ynnklx/testbench/README.md

# Testbench – motor and propeller test stand

A test stand to measure small brushless motors with propellers: **thrust,
current, voltage, RPM and ESC temperature**. It runs on a lab power supply.

The main goal is not the most precise number. The goal is a measurement
process that is **traceable, reproducible and honest about its errors**:
every result file says where it comes from, raw data is never changed, and
every point that looks wrong is marked, not deleted.

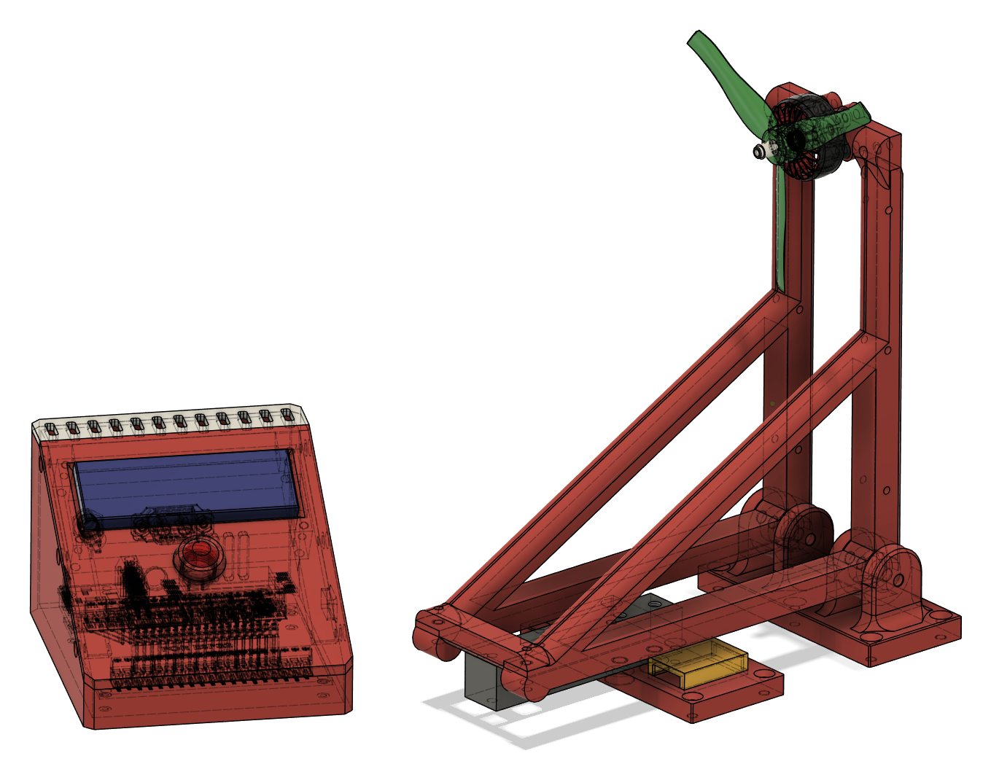
[picture p1: docs/images/title_render.png]
Test stand (CAD rendering): controller box and load cell rig


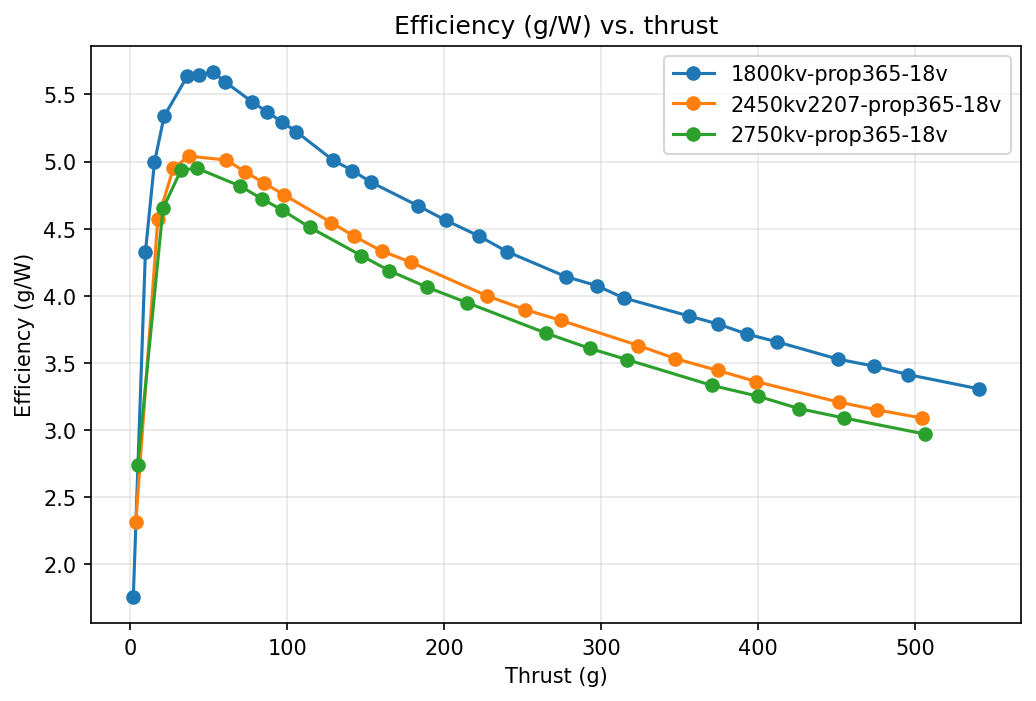
[picture p2: data/plots/Hauptmessreihe/1800kv-prop365-18v_vs_2450kv2207-prop365-18v_vs_2750kv-prop365-18v_efficiency_vs_thrust.png]
Efficiency vs. thrust, three motors at 18 V


*Efficiency (g/W) over thrust for three motors with the same propeller at
18 V. Each curve is the combination of two repeated runs.*

## Documentation

[Projektdokumentation (PDF, German)](docs/Testbench_Dokumentation_GER.pdf)

Full project documentation in German: concept, mechanical and electronic design,
test automation, validation and results. An English version is available on request.

## Video: Demo Run (YouTube)

Automated test run on the thrust stand (https://youtu.be/bWamTexU-FU)

Automated test run from start to finish: arming, 3 s countdown with zero-point capture,
throttle sweep up and down in 2.5% steps, and live data acquisition on the host PC.

## How it works

```
ESP32 firmware  ->  Acquisition  ->  Analysis  ->  Comparison  ->  Plots
 raw ADC counts      RAW.csv        ANALYZED.csv   COMPARISON.csv   *.png
```

- The **firmware** (ESP32, C++, PlatformIO) reads the load cell (HX711), the
  current/voltage sensor (INA226) and the ESC telemetry. It sends only raw
  values with a timestamp per sample. It drives the throttle sequence by
  itself: up to full throttle in 2.5 % steps and down again.
- The **host software** (Python) records the data, makes one measurement point
  per throttle stage, checks each point against rules (VALID / WARNING /
  INVALID), compares repeated runs and draws plots.
- Calibration happens on the host. So old data can be recalculated when the
  calibration changes.

Details and reasons for each decision: [docs/ARCHITECTURE.md](docs/ARCHITECTURE.md).

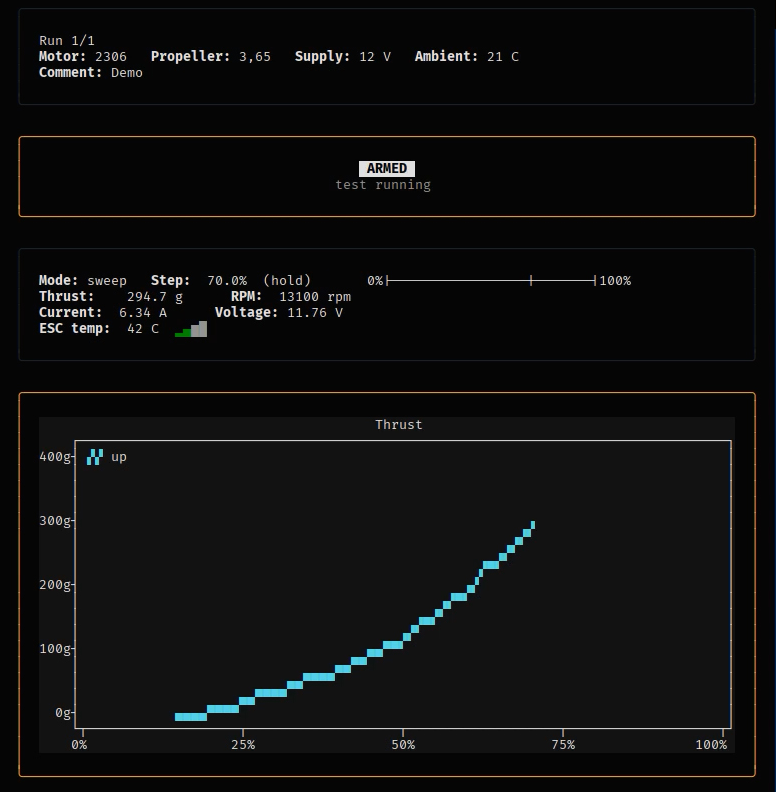
[picture p3: docs/images/session_live_view.png]
Live view during a sweep


*Live view of `testbench.py session` during a sweep (2306 motor, 12 V).*

## Validation

Before the main series, the measurement chain was checked against reference
weights, a multimeter and repeated runs. Repeated runs agree within about 1 %
for thrust and current, and the current measurement is within about 2 % of a
multimeter. Details in [docs/DEVLOG.md](docs/DEVLOG.md).

## Usage

Python 3.10 or newer.

```bash
pip install pyserial numpy pandas matplotlib rich textual textual-plotext
```

### Measuring with the test stand

The ESP32 is connected via USB (default port `/dev/ttyUSB0`, change with
`--port`). The run itself is started on the device with the arm button.

```bash
# Guided session: short setup questions, live view during the run,
# results and plots after the last repetition
python testbench.py session

# Or only record RAW files, without questions
python testbench.py record

# Load cell calibration with reference weights
python testbench.py calibrate
```

### Evaluating data

Every stage can also be started alone, for example to analyze old RAW files
again with a changed `validation.json`:

```bash
python testbench.py analyze data/raw/Hauptmessreihe/2026-09-17_13-58-33_sweep_1of2_RAW.csv
python testbench.py compare --label <name> <ANALYZED file> <ANALYZED file> ...
python testbench.py plot --kind g_per_w_vs_thrust <COMPARISON file> ...
```

Run `python testbench.py <command> --help` for all options.

### Development

- Firmware: `cd firmware && pio run`
- Tests: `python -m pytest`
- `record` and `session` accept `--simulate`. A built-in simulator then
  replaces the device, so the software can be tested without the test stand.
  The simulated values are not real measurements.

## Repository structure

| Path | Content |
|---|---|
| `firmware/` | ESP32 firmware: HX711 driver, INA226, ESC control and telemetry, serial protocol |
| `acquisition/` | Serial link (with simulator), recorder, guided session, calibration |
| `analysis/` | RAW → ANALYZED: measurement points, statistics, validation rules |
| `comparison/` | Run-to-run comparison and plots |
| `core/` | File names, CSV headers, units, calibration |
| `config/` | `calibration.json` (load cell fit), `validation.json` (all thresholds, each with its source) |
| `data/` | Real measurement data, see [data/README.md](data/README.md) |
| `tests/` | Automated tests (pytest) |
| `docs/` | Architecture, development log, [HX711 outlier finding](docs/findings/hx711-outlier.md) |

## Hardware

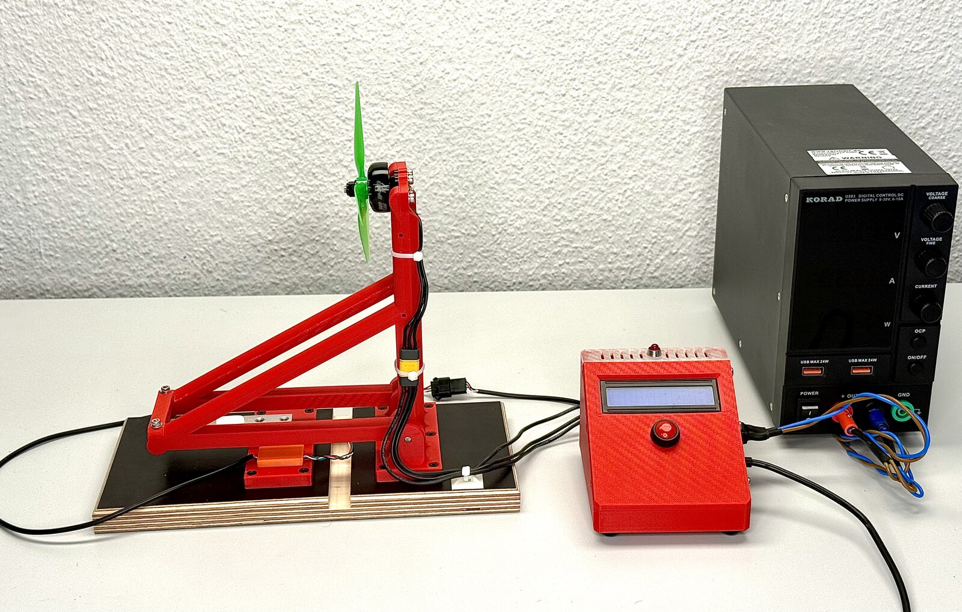
[picture p4: docs/images/setup.jpg]
Complete setup with lab power supply


*Load cell rig with motor and propeller (left), controller box (middle),
lab power supply (right).*

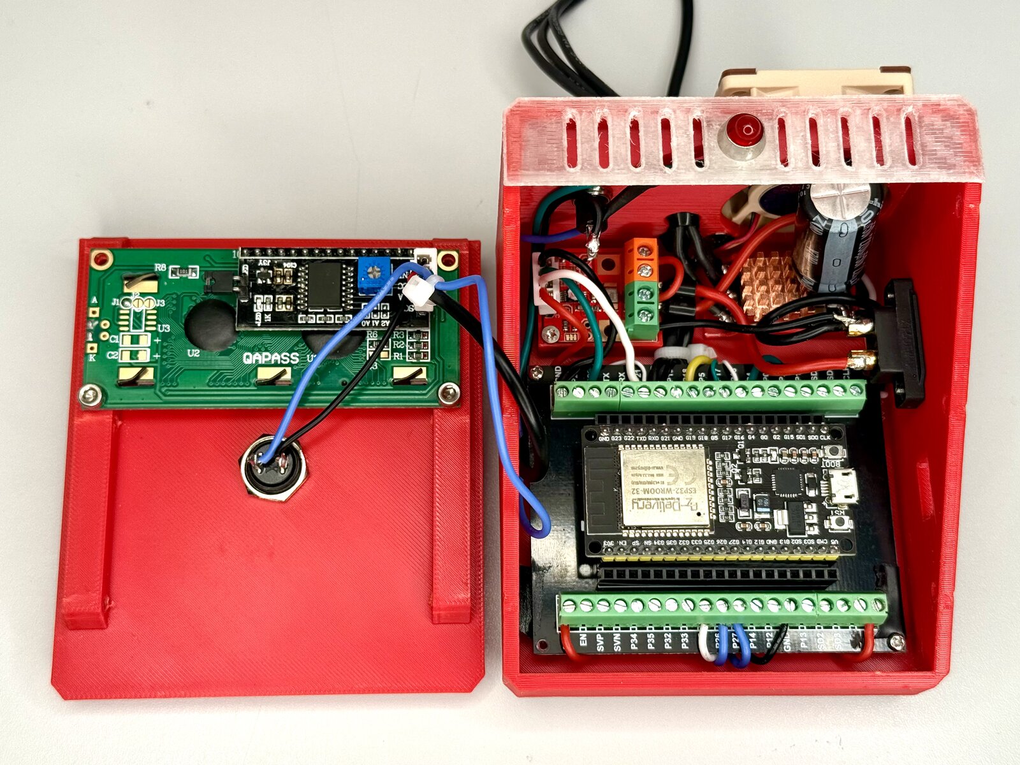
[picture p5: docs/images/controller.jpg]
Controller box opened


*Inside the controller box: ESP32 on a screw terminal board, current sensor
and ESC with active cooling. Display and arm button in the lid.*

ESP32 WROOM-32, 2 kg load cell with HX711, INA226 current sensor
(0.002 Ω shunt), T-Hobby F35A ESC (AM32 firmware), lab power supply 10 A.
Frame and housing are 3D printed. Full list and pin assignment in
[docs/ARCHITECTURE.md](docs/ARCHITECTURE.md#hardware).

## Development with AI support

The firmware and the Python tools were implemented with the help of Claude
Code. I defined the test concept, requirements, test logic, interfaces and
validation strategy myself. The resulting measurement chain was then checked
with independent measuring equipment.

## Safety and disclaimer

This is a private project, documented for learning and reference. It is not
a certified measuring device and not a finished product.

Spinning propellers can cause serious injuries. Power supplies and batteries
can deliver high currents and cause fire. If you build or use anything from
this repository, you do so at your own risk. Mount the rig securely, stay out
of the propeller plane, remove the propeller while working on the setup and
never leave a running test unattended.

Check the motor direction and the propeller orientation before every run.
The thrust must press the rocker onto the load cell. With a wrong
combination the thrust points the other way and the rocker can flip over.
There is no failsafe for this: neither the firmware nor the mechanics
detect it.

The software, CAD files and documentation are provided "as is", without
warranty of any kind. To the extent permitted by law, the author accepts no
liability for damage or injury resulting from their use.
