ynnklx/testbench/data/plots/Demo/2026-10-09_21-32-32_2306-prop365-12v_power_vs_thrust.png

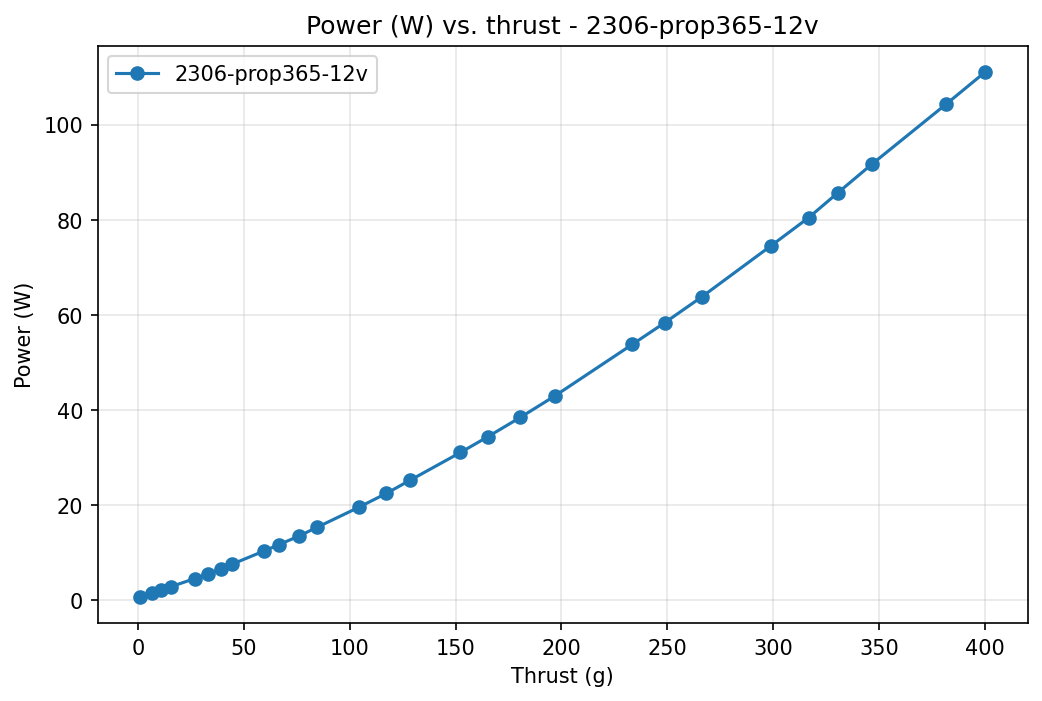
data/plots/Demo/2026-10-09_21-32-32_2306-prop365-12v_power_vs_thrust.png
