ynnklx/testbench/data/plots/Hauptmessreihe/1800kv-prop365-12v_vs_1800kv-prop365-15v_vs_1800kv-prop365-18v_power_vs_thrust.png

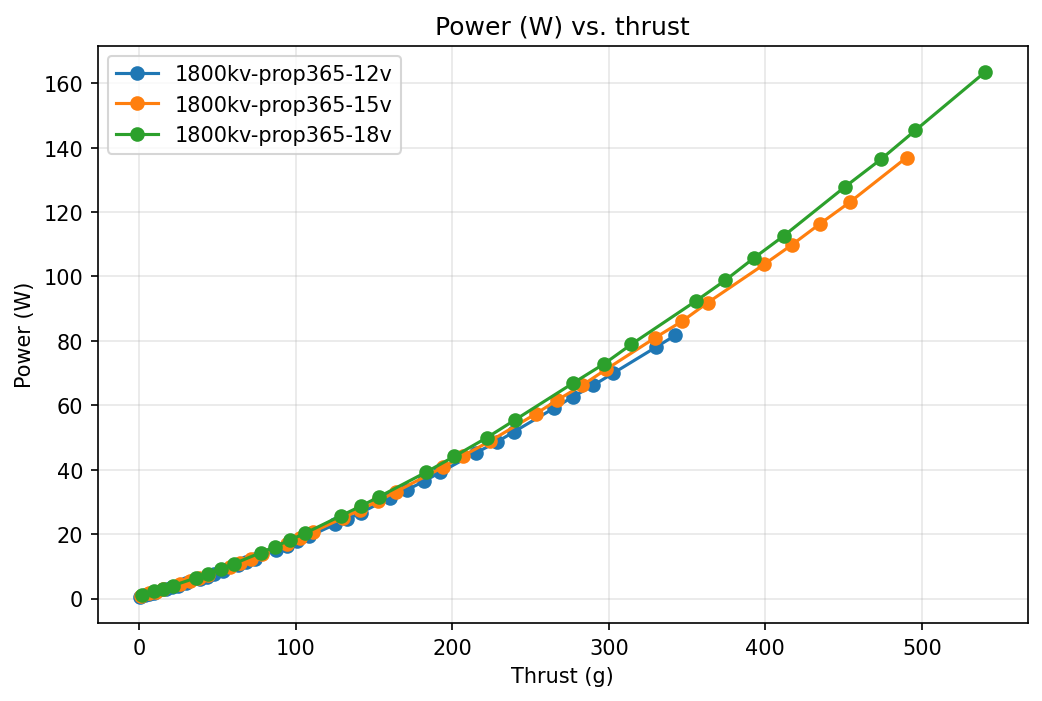
data/plots/Hauptmessreihe/1800kv-prop365-12v_vs_1800kv-prop365-15v_vs_1800kv-prop365-18v_power_vs_thrust.png
