ynnklx/testbench/data/plots/Hauptmessreihe/2026-10-09_21-32-33_2750kv-prop365-18v_thrust.png

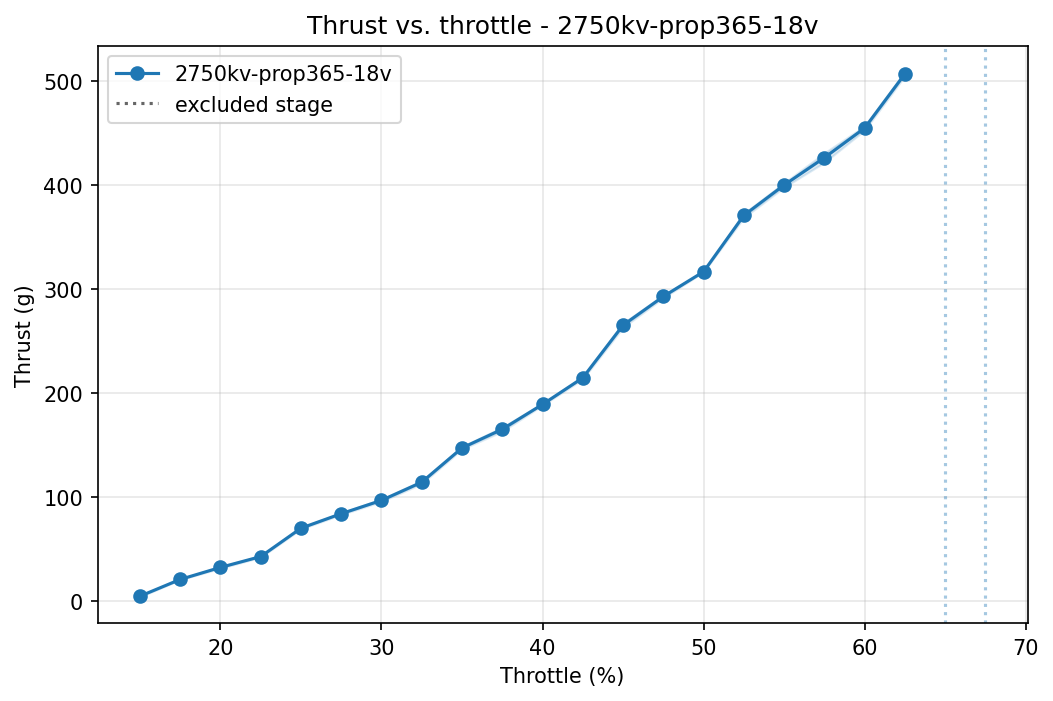
data/plots/Hauptmessreihe/2026-10-09_21-32-33_2750kv-prop365-18v_thrust.png
