ynnklx/testbench/data/plots/Hauptmessreihe/2450kv2207-prop365-12v_vs_2450kv2207-prop365-15v_vs_2450kv2207-prop365-18v_efficiency_vs_thrust.png

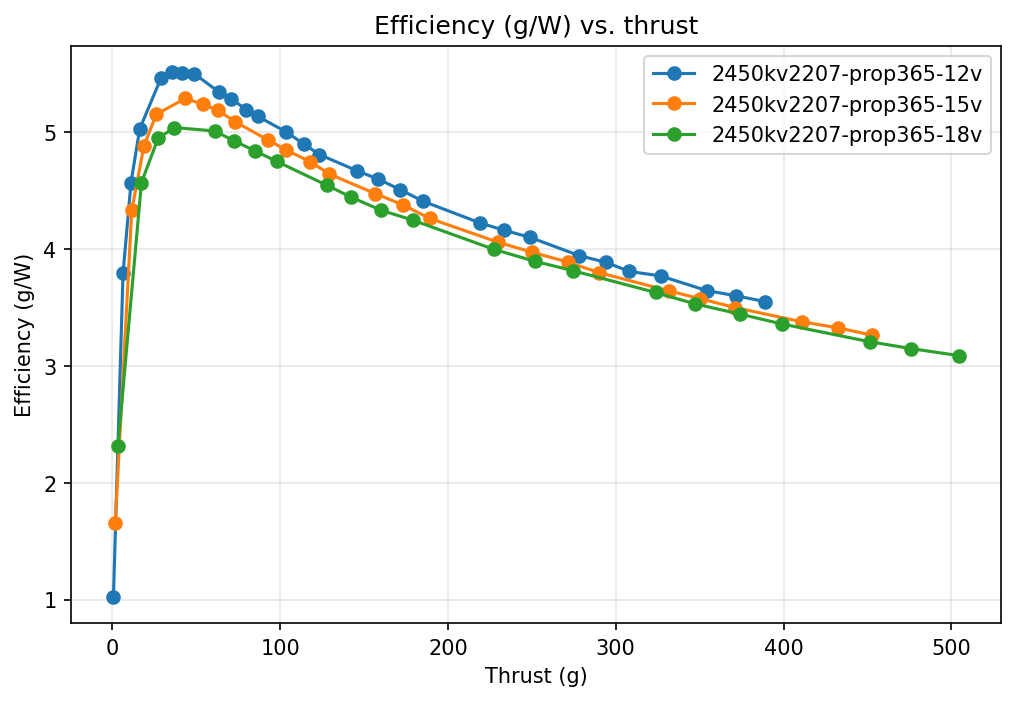
data/plots/Hauptmessreihe/2450kv2207-prop365-12v_vs_2450kv2207-prop365-15v_vs_2450kv2207-prop365-18v_efficiency_vs_thrust.png
