ynnklx/testbench/data/plots/Hauptmessreihe/2750kv-prop365-12v_vs_2750kv-prop365-15v_vs_2750kv-prop365-18v_efficiency_vs_thrust.png

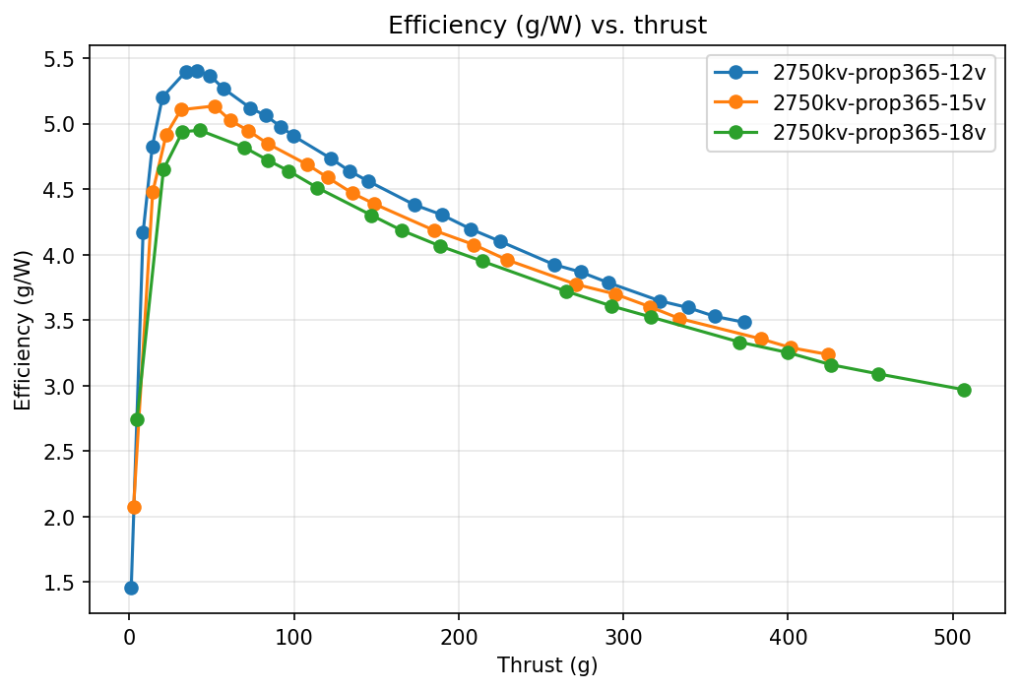
data/plots/Hauptmessreihe/2750kv-prop365-12v_vs_2750kv-prop365-15v_vs_2750kv-prop365-18v_efficiency_vs_thrust.png
