ynnklx/testbench/CAD/controller_housing_assembly.step

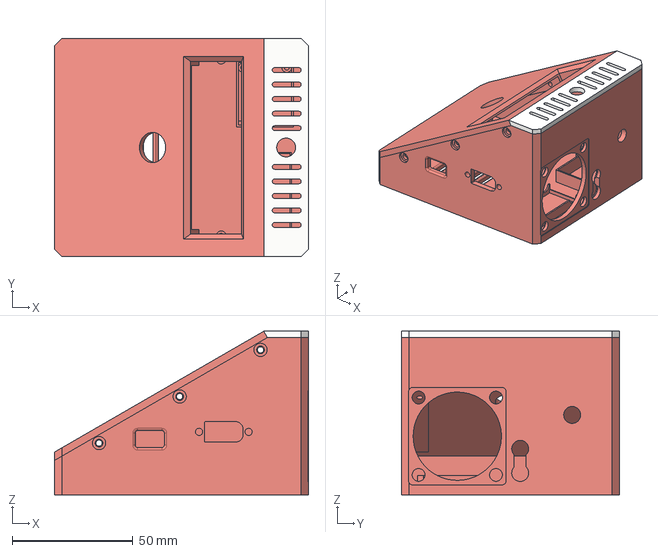
[picture p16: CAD file, 2026-10-12]
CAD/controller_housing_assembly.step
105.0 x 90.0 x 67.6 mm
