ynnklx/testbench/CAD/Testbench_assambly.step

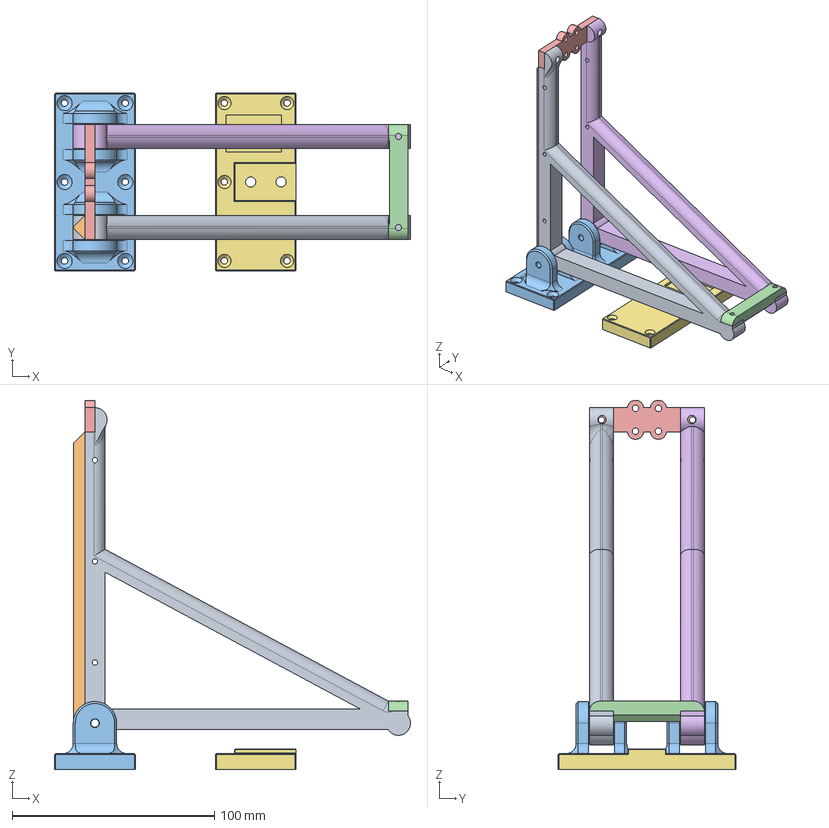
[picture p17: CAD file, 2026-10-12]
CAD/Testbench_assambly.step
176.0 x 88.0 x 182.7 mm
