ynnklx/testbench/CAD/Arm_2x.stl

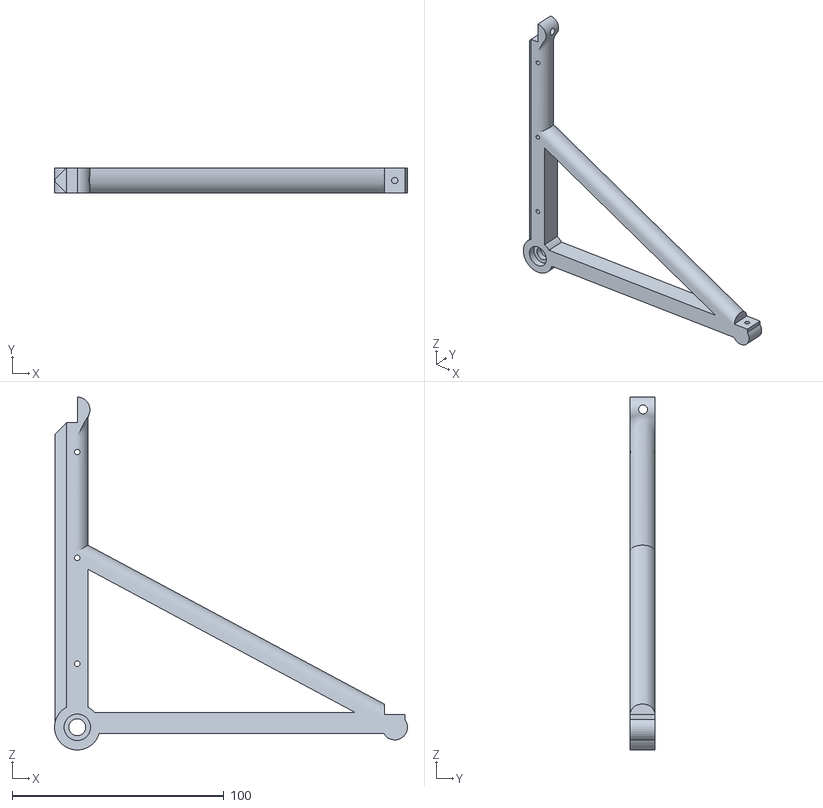
[picture p18: CAD file, 2026-10-12]
CAD/Arm_2x.stl
166.7 x 12.0 x 166.7
