ynnklx/testbench/CAD/controller_lid.stl

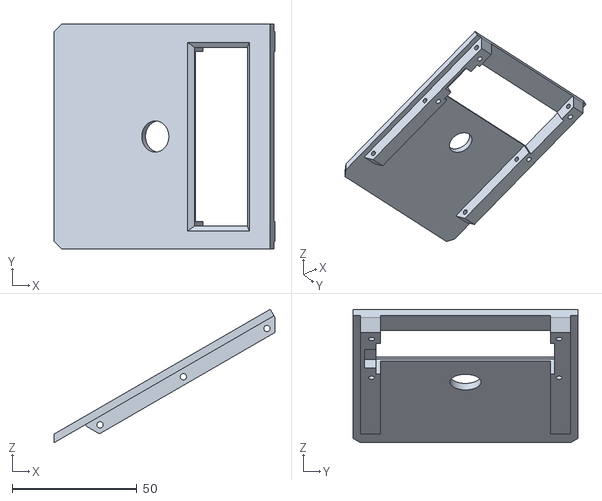
[picture p19: CAD file, 2026-10-12]
CAD/controller_lid.stl
88.4 x 90.0 x 53.4
