ynnklx/testbench/CAD/motor_mount.stl

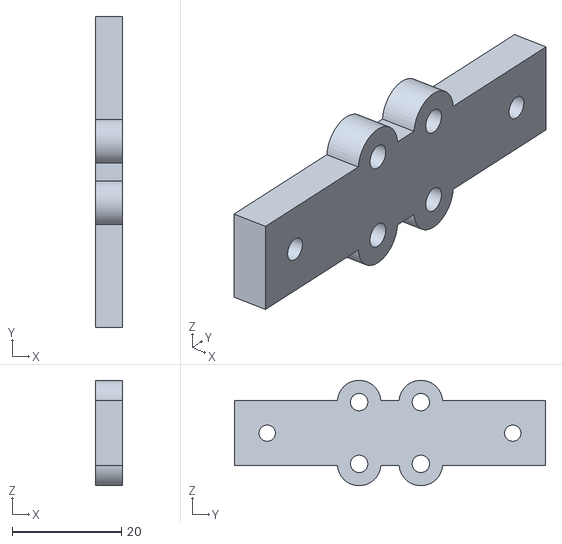
[picture p20: CAD file, 2026-10-12]
CAD/motor_mount.stl
5.00 x 57.0 x 19.3
