ynnklx/testbench/CAD/hx711_lid.stl

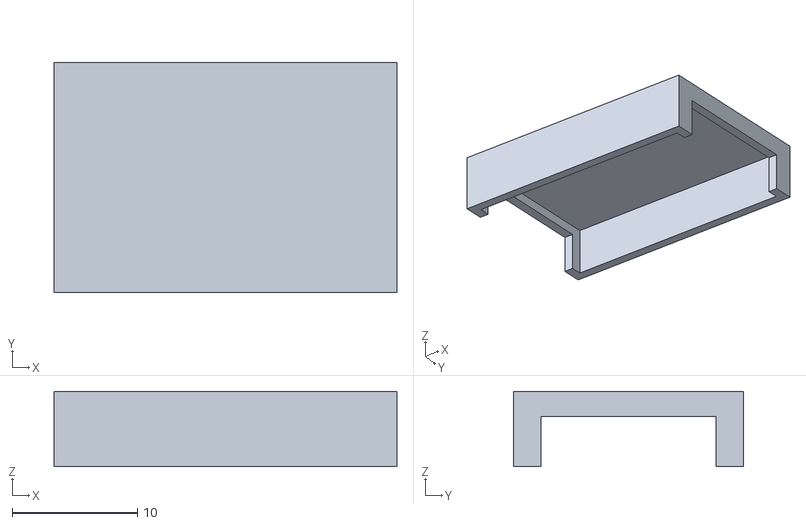
[picture p21: CAD file, 2026-10-12]
CAD/hx711_lid.stl
27.4 x 18.4 x 6.00
