ynnklx/testbench/CAD/controller_base.stl

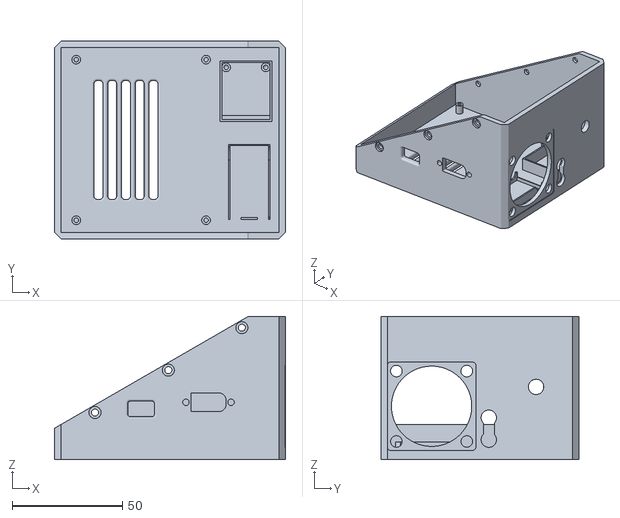
[picture p22: CAD file, 2026-10-12]
CAD/controller_base.stl
105.0 x 90.0 x 65.0
