ynnklx/testbench/CAD/cell_mount.stl

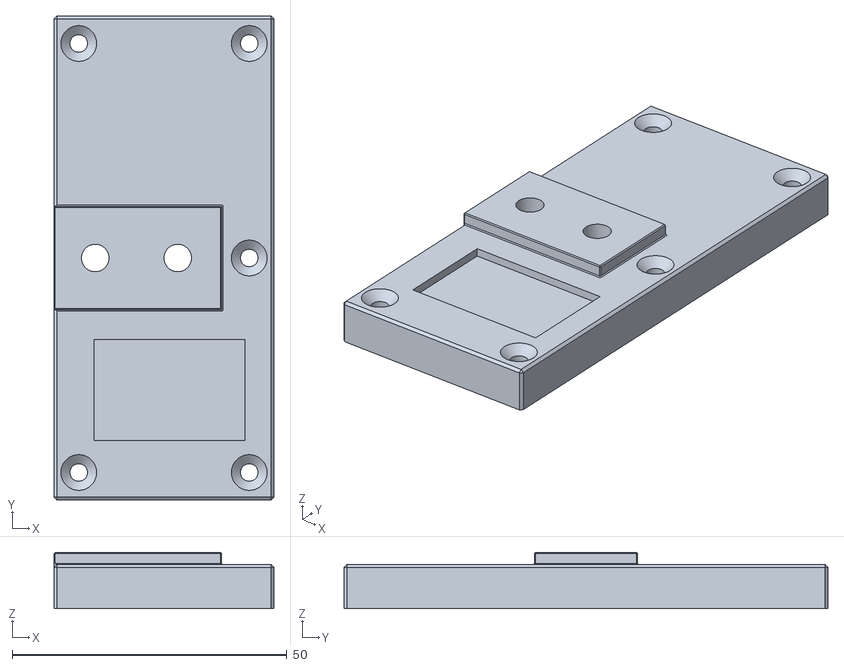
[picture p23: CAD file, 2026-10-12]
CAD/cell_mount.stl
40.0 x 88.0 x 10.2
