ynnklx/testbench/CAD/pivot_mount.stl

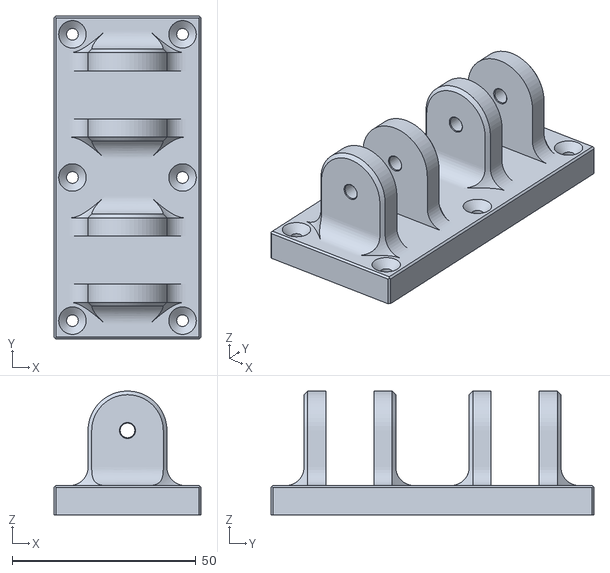
[picture p24: CAD file, 2026-10-12]
CAD/pivot_mount.stl
40.0 x 88.0 x 33.7
