ynnklx/testbench/CAD/force_bridge.stl

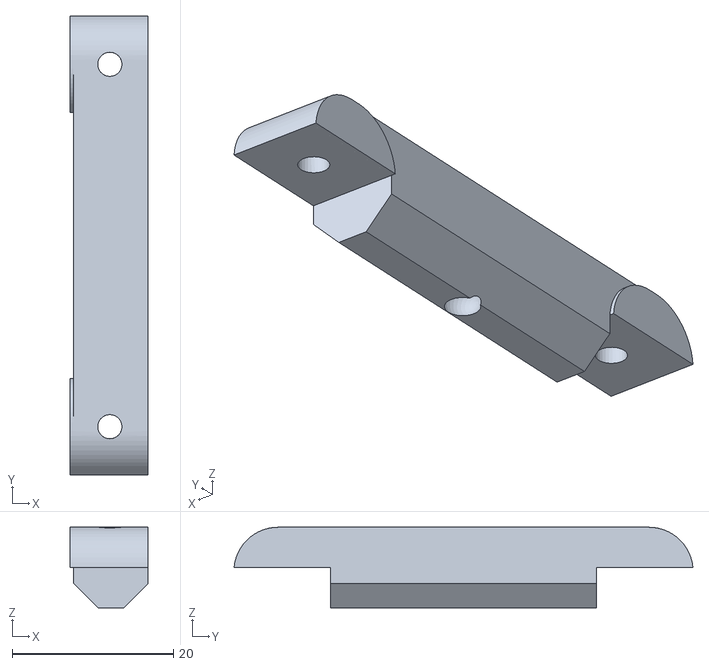
[picture p25: CAD file, 2026-10-12]
CAD/force_bridge.stl
9.67 x 57.0 x 10.0
