ynnklx/testbench/CAD/drilling_template.stl

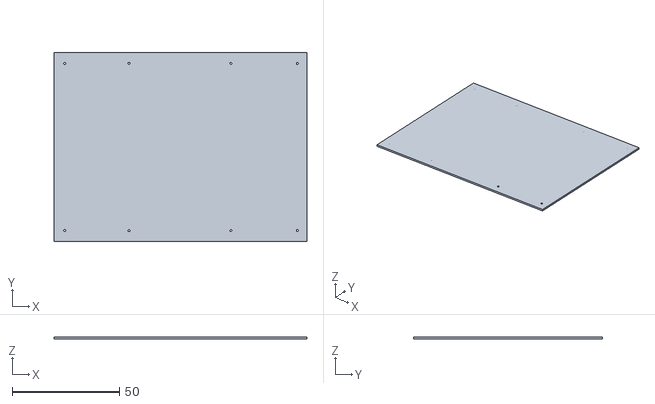
[picture p26: CAD file, 2026-10-12]
CAD/drilling_template.stl
118.0 x 88.0 x 1.00
