ynnklx/testbench/CAD/controller_vent_cover.stl

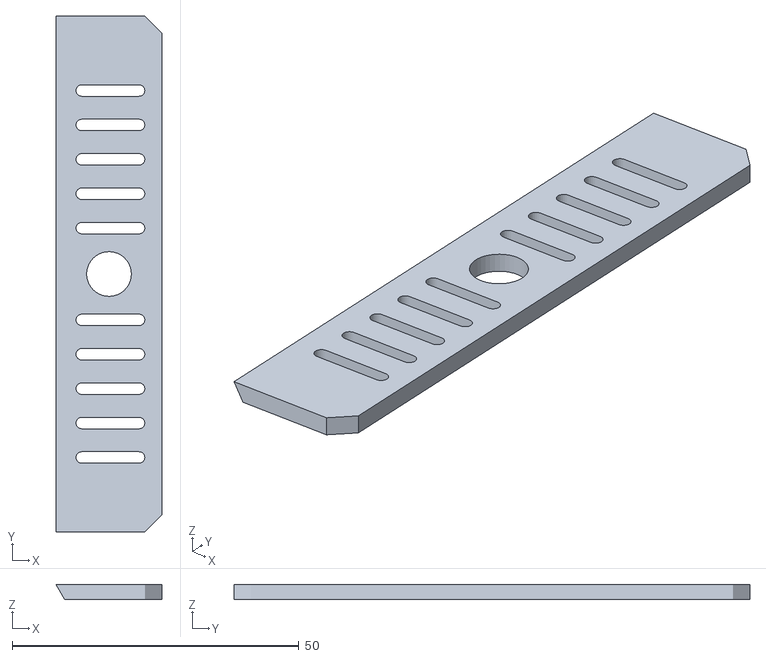
[picture p27: CAD file, 2026-10-12]
CAD/controller_vent_cover.stl
18.5 x 90.0 x 2.60
