ynnklx/testbench/(commit log)

2026-10-09 Motor and propeller test stand V2
    ESP32 firmware (raw values, own HX711 driver, autonomous up/down sweep),
    host pipeline RAW -> ANALYZED -> COMPARISON -> plots with validation rules
    and full provenance, tests, documentation and the main measurement series.
    [2026-09-17_13-58-33_sweep_1of2_ANALYZED.csv, 2026-09-17_13-58-33_sweep_1of2_RAW.csv, 2026-09-17_14-02-50_sweep_2of2_ANALYZED.csv, 2026-09-17_14-02-50_sweep_2of2_RAW.csv, 2026-09-17_14-08-34_sweep_1of2_ANALYZED.csv, 2026-09-17_14-08-34_sweep_1of2_RAW.csv, 2026-09-17_14-13-05_sweep_2of2_ANALYZED.csv, 2026-09-17_14-13-05_sweep_2of2_RAW.csv]
2026-10-09 Re-analyze published data with current thresholds, align AI note
    All measured values and comparison results are unchanged; 101 of 554
    points move from WARNING to VALID, INVALID points are unchanged.
    [2026-09-17_13-58-33_sweep_1of2_ANALYZED.csv, 2026-09-17_14-02-50_sweep_2of2_ANALYZED.csv, 2026-09-17_14-08-34_sweep_1of2_ANALYZED.csv, 2026-09-17_14-13-05_sweep_2of2_ANALYZED.csv, 2026-09-17_14-32-18_sweep_1of2_ANALYZED.csv, 2026-09-17_14-37-00_sweep_2of2_ANALYZED.csv, 2026-09-17_14-41-59_sweep_1of2_ANALYZED.csv, 2026-09-17_14-45-42_sweep_2of2_ANALYZED.csv]
2026-10-09 README: add CAD rendering, photos of the setup and live view screenshot
